davidooi0128-glitch/medicine-dispenser-for-MCM-competition-2025/slide 2 document.docx

# PILL PING — The Hardware Architecture and Innovation

### 1: Hygienic Liquid Delivery (Peristaltic Pump)

- Operating Principle: Operates on a planetary gearbox kinematic model. The central motor shaft acts as the sun gear, driving three planetary rollers to compress medical-grade silicone tubing in a peristaltic motion.
- Biomedical Safety: Complete physical isolation of liquid media. Fluid path is restricted strictly inside the silicone tube, eliminating cross-contamination and reagent oxidation.
- Control Mechanism: High-torque DC motor driven via relay switch.

### 2: Closed-Loop Liquid Dosing (Hall-Effect Encoder)

- Feedback Architecture: Rear-shaft mounted PCB featuring a magnetic encoder disc and Hall-effect sensing elements.
- Signal Acquisition: Generates high-frequency pulse interrupts directly to the microcontroller upon shaft rotation.
- Performance Metric: Enables closed-loop volume metering down to 0.01 mL (10 µL), compensating for liquid viscosity changes and voltage dips.

### 3: PWM Servo Motor vs. Stepper Motor Actuation Analysis

Parameter | PWM Servo Motor (Selected) | Stepper Motor (Alternative Rejected)
Control Architecture | Closed-loop (Internal potentiometer feedback) | Open-loop (Step counting)
Power Consumption | Dynamic (Draws current only under load) | Constant static power draw (Holding torque)
Homing Requirement | Not required (Absolute position feedback) | Requires dedicated homing/limit switch
Fault Tolerance | Self-correcting against external blockage | Vulnerable to lost steps during jamming

### 4: Pill Drop Verification (Laser Optical Sensor)

- Sensor Topology: Cross-chute opposing laser emitter and photodiode detector pair (PIN_LASER).
- Verification Protocol: Interruption of the optical beam triggers a hardware interrupt.
- Data Integrity: Medication dispensation logs are updated in EEPROM only after verified physical passage of a solid pill through the beam, preventing false-positive dispensing records.

### 5: Smart Rotary Solid Dispenser

- Mechanical Structure: Custom 3D-printed multi-compartment indexing wheel driven by servo micro-stepping.
- Dispensing Kinematics: Programmatic angular indexing isolates individual solid doses, ensuring exactly one pill is released per rotation cycle.

### 6: Dedicated IoT Web Server (ESP8266 Module)

- Networking Protocol: Configured in standalone Access Point (SoftAP) mode hosting a lightweight HTTP Web Server.
- User Interface: Zero-dependency browser interface for schedule management (dosing window, target pulse count, pill quantities) without requiring external app installations.

## 7. Dual-MCU Architecture & Hardware Resource Allocation

The system decouples network communication from real-time hardware execution using a Dual-MCU topology.

Feature / Resource | Arduino Core (ATmega328P) | ESP8266 Module | System Task Division
Pin Density | 14 Digital I/O (6 PWM) + 8 Analog (A0–A7) | Extremely limited (~4 usable GPIOs) | Arduino: Handles 10+ sensors/actuators. ESP8266: Dedicated network stack.
Hardware Interrupts | Fast hardware pin interrupts (D2, D3) | Shared with Wi-Fi stack | Arduino: Zero-latency Hall pulse counting and laser beam break detection.
Communication Buses | Hardware I2C (SDA/SCL), SPI, Native UART | Software I2C, UART | Arduino: Direct interface with I2C LCD, Servo PWM, and Analog Sensors.
Memory Isolation | 1 KB Non-Volatile EEPROM | Flash Memory / SPIFFS | Arduino: Stores dosage schedules safely against power failure.

### Inter-MCU Protocol & Data Persistence

1. Communication Protocol: SoftwareSerial UART bridge at 9600 baud (Arduino D2/D3 $\leftrightarrow$ ESP8266 TX/RX).
2. Payload Framing: Data transmitted using framed ASCII packets: <Doses,Start,End,Remind,Pulses,Pills>.
3. Data Security: Parsed schedules are immediately saved into the Arduino core’s internal EEPROM, preserving dosage timing through sudden power losses.

## 8. Audio-Visual Alert System (Module 8)

- Multi-Modal Warning: High-decibel piezo buzzer coupled with high-luminance flashing LED arrays.
- Escalation Protocol: Triggers active alerting during scheduled dosing windows. Escalates tone patterns if dosage remains uncollected past the target end time.

————————————————————————————————————————————————————

## Future Roadmap & Enterprise Hospital Expansion

### Phase 1: RFID Patient Authentication (Public Hospital Corridors)

- Target Environment: Transition from home care to ward corridors and communal hospital areas.
- Implementation: Integration of an SPI/I2C RFID reader (e.g., RC522) to the Arduino core. Patients wearing encoded RFID wristbands scan at hallway stations to receive scheduled medication on demand, reducing nursing workload.

### Phase 2: Centralized Network Management

- Infrastructure: Integration of SPI-based W5500 Ethernet modules or Enterprise WPA2 Wi-Fi bridges.
- Functionality: Enables central nursing stations to monitor live dispensing status, track adherence logs, and push real-time schedule adjustments across entire hospital floors.

### Phase 3: Modular Hardware Expansion

Frame Design: Physical chassis featuring standardized snap-on sliding rails.

Stackable Modules: Auxiliary 3D-printed "Servo + Rotary Wheel" and "Peristaltic Pump" modules connect via extended I2C/PWM buses, dynamically scaling solid tablet and liquid capacity without redesigning the main controller board.

EXPLODED VIEW :

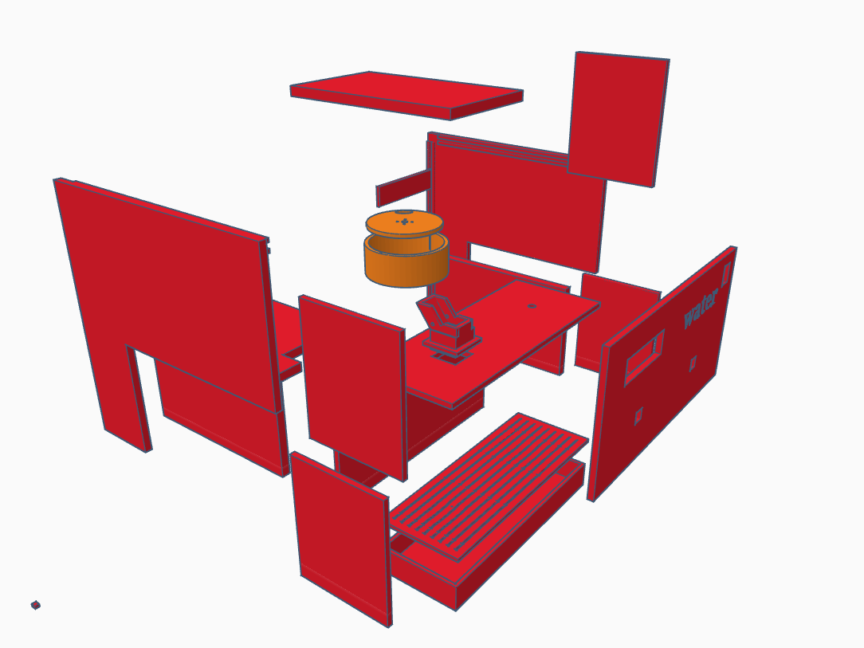
[picture p1: figure]
