davidooi0128-glitch/medicine-dispenser-for-MCM-competition-2025/arduino expension/PCB PDF (1).pdf

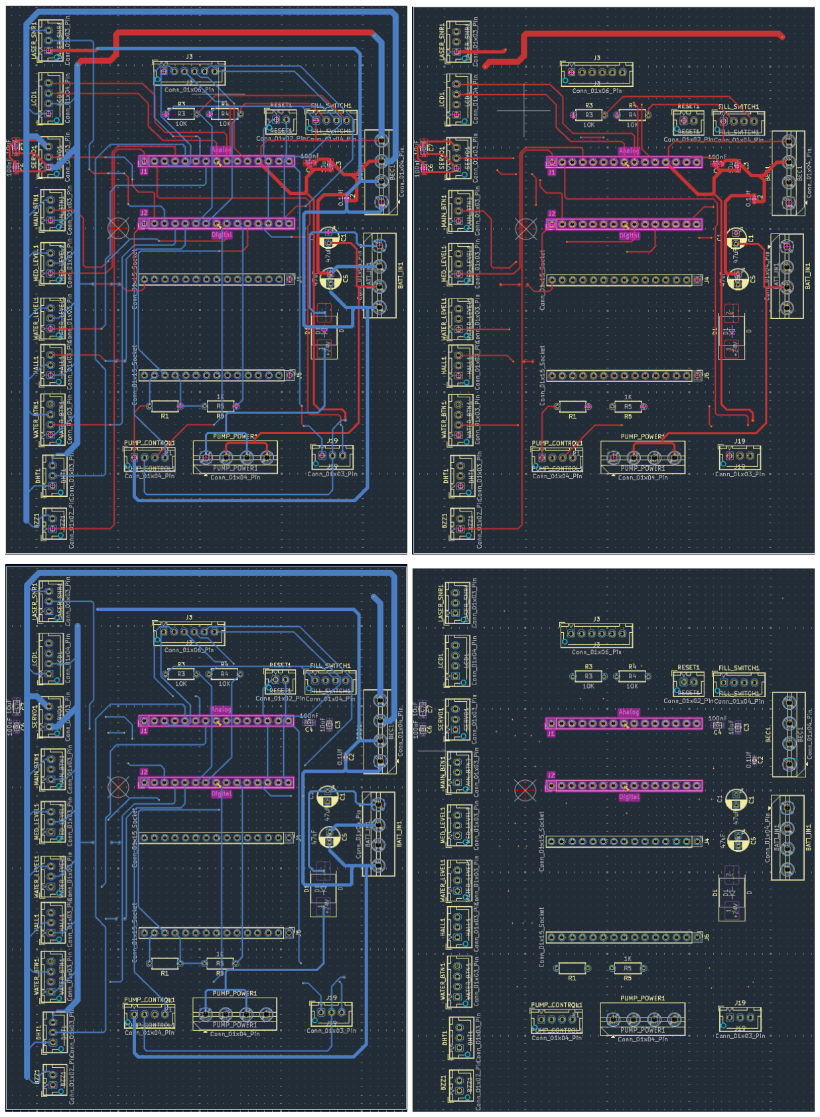
[picture p2: page 1]
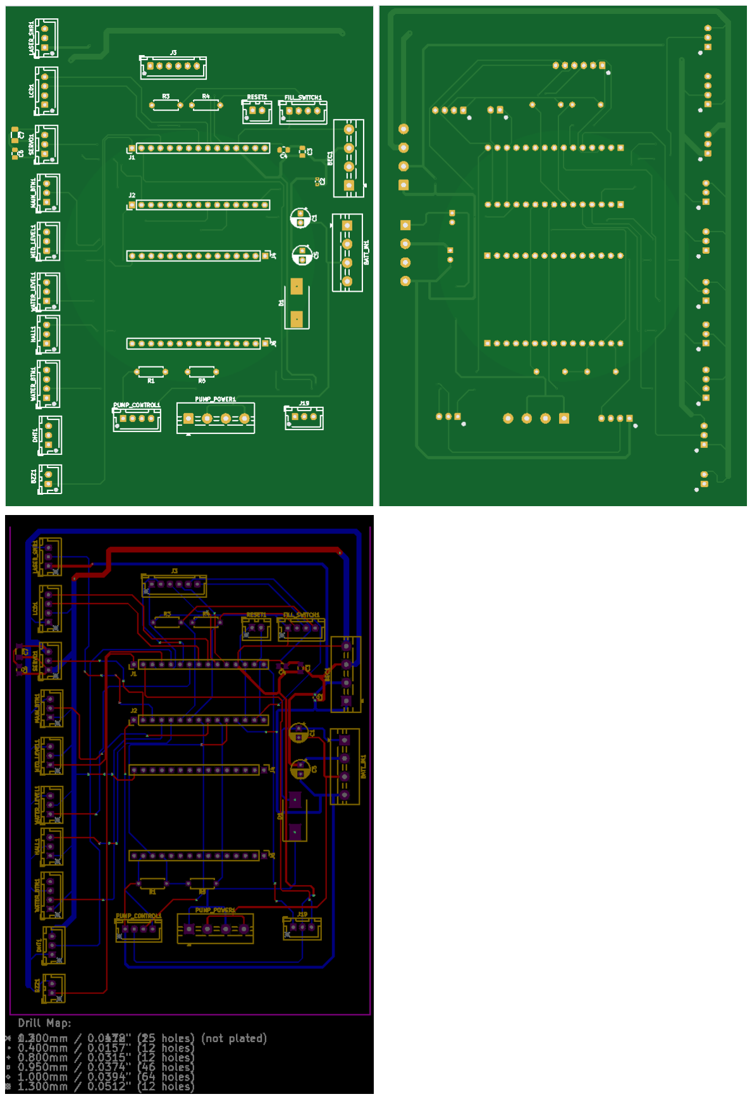
[picture p3: page 2]

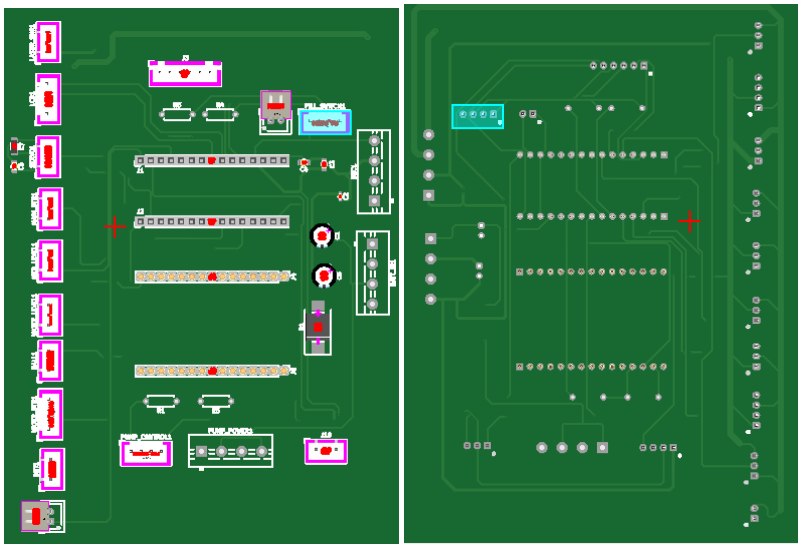
[picture p4: figure]
