davidooi0128-glitch/medicine-dispenser-for-MCM-competition-2025/display board-20260913T150620Z-1-001/display board/2.png

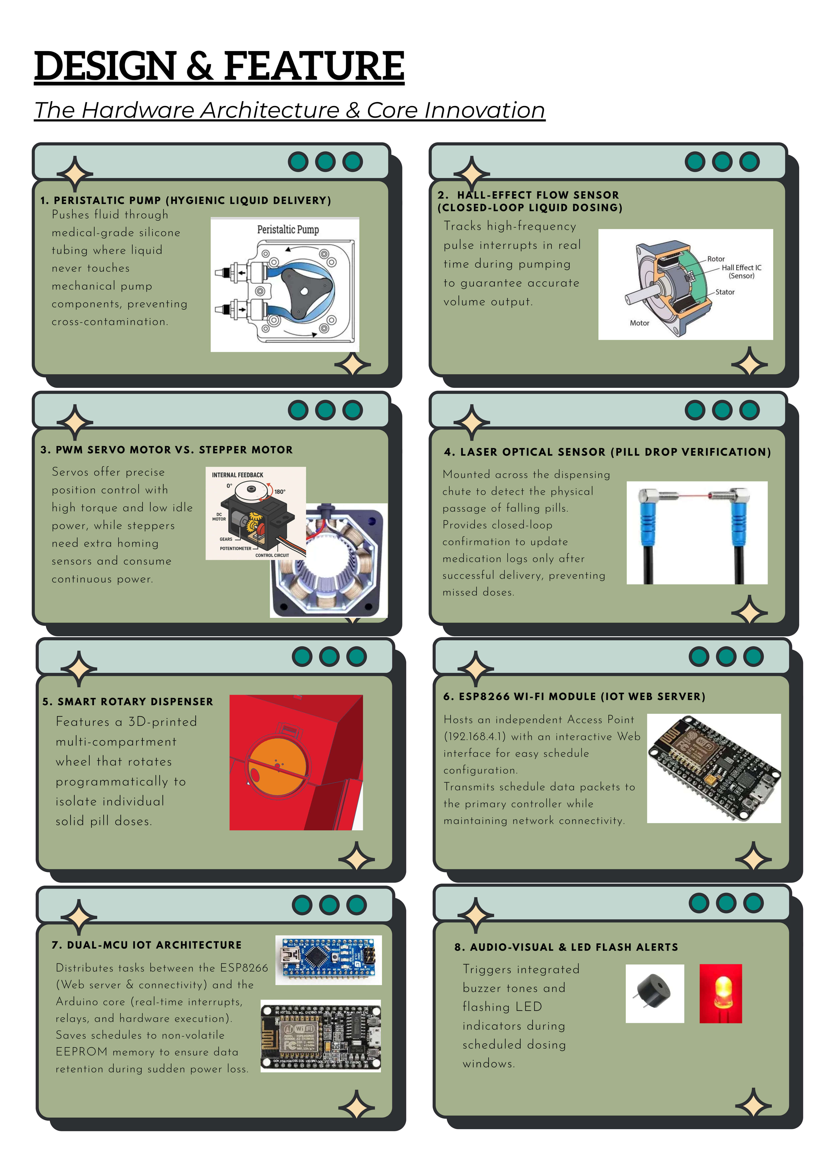
display board-20260913T150620Z-1-001/display board/2.png
