davidooi0128-glitch/medicine-dispenser-for-MCM-competition-2025/Screenshot_2026-09-13-14-38-49-51_40deb401b9ffe8e1df2f1cc5ba480b12.jpg

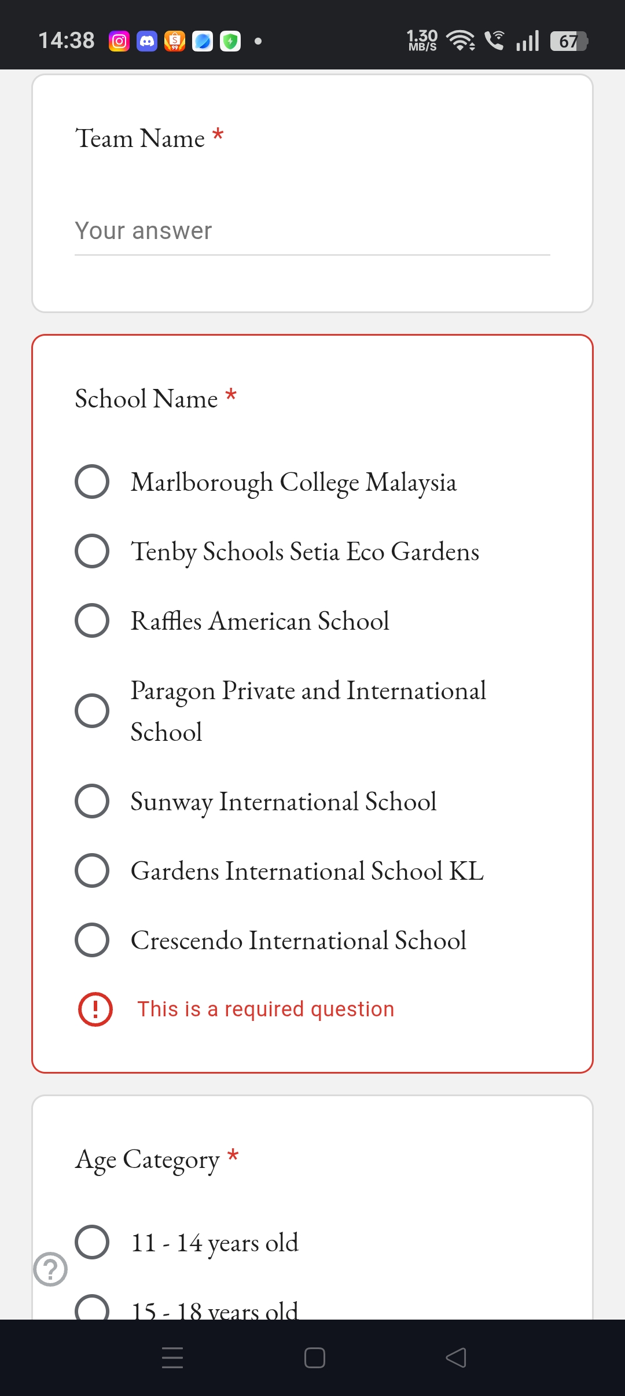
Screenshot_2026-09-13-14-38-49-51_40deb401b9ffe8e1df2f1cc5ba480b12.jpg
