davidooi0128-glitch/medicine-dispenser-for-MCM-competition-2025/arduino expension/production/bom.csv

Designator | Footprint | Quantity | Value | LCSC Part #
BATT_IN1, BEC1, PUMP_POWER1 | TerminalBlock_MaiXu_MX126-5.0-04P_1x04_P5.00mm | 3 | Conn_01x04_Pin
BZZ1, RESET1 | JST_XH_B2B-XH-AM_1x02_P2.50mm_Vertical | 2 | Conn_01x02_Pin
C1, C5 | CP_Radial_D5.0mm_P2.50mm | 2 | 47uF
C2 | 0603 | 1 | 0.1Uf
C3 | 0805 | 1 | 10uF
C4, C6 | 0805 | 2 | 100nF
C7 | 1206 | 1 | 10uF
D1 | D_SMC_Handsoldering | 1 | D
DHT1, HALL1, J19, LASER_SNR1, MAIN_BTN1, MED_LEVEL1, SERVO1, WATER_LEVEL1 | JST_XH_B3B-XH-AM_1x03_P2.50mm_Vertical | 8 | Conn_01x03_Pin
FILL_SWITCH1, LCD1, PUMP_CONTROL1 | JST_XH_B4B-XH-AM_1x04_P2.50mm_Vertical | 3 | Conn_01x04_Pin
J1 | PinHeader_1x15_P2.54mm_Vertical | 1 | Analog
J2 | PinHeader_1x15_P2.54mm_Vertical | 1 | Digital
J3 | JST_XH_B6B-XH-AM_1x06_P2.50mm_Vertical | 1 | Conn_01x06_Pin
J4, J6 | PinHeader_1x15_P2.54mm_Vertical | 2 | Conn_01x15_Socket
R1 | R_Axial_DIN0207_L6.3mm_D2.5mm_P7.62mm_Horizontal | 1 | 2K
R3, R4 | R_Axial_DIN0207_L6.3mm_D2.5mm_P7.62mm_Horizontal | 2 | 10K
R5 | R_Axial_DIN0207_L6.3mm_D2.5mm_P7.62mm_Horizontal | 1 | 1K
WATER_BTN1 | JST_XH_B4B-XH-AM_1x04_P2.50mm_Vertical | 1 | Conn_01x03_Pin
