davidooi0128-glitch/medicine-dispenser-for-MCM-competition-2025/arduino expension/arduino expension.csv

Reference | Value | Datasheet | Footprint | Qty | DNP
C1,C2,C3,C4,C5,C6,C7 | C |  | Capacitor_SMD:C_0603_1608Metric,Capacitor_SMD:C_0805_2012Metric_Pad1.18x1.45mm_HandSolder,Capacitor_SMD:C_1206_3216Metric_Pad1.33x1.80mm_HandSolder,Capacitor_THT:CP_Radial_D5.0mm_P2.50mm | 7
D1 | D |  | Diode_SMD:D_SMC_Handsoldering | 1
J1 | Analog |  | Connector_PinHeader_2.54mm:PinHeader_1x15_P2.54mm_Vertical | 1
J2 | Digital |  | Connector_PinHeader_2.54mm:PinHeader_1x15_P2.54mm_Vertical | 1
J3 | Conn_01x06_Pin |  | Connector_JST:JST_XH_B6B-XH-AM_1x06_P2.50mm_Vertical | 1
J4,J6 | Conn_01x15_Socket |  | Connector_PinHeader_2.54mm:PinHeader_1x15_P2.54mm_Vertical | 2
J5,J7,J8,J13,J20,J21 | Conn_01x04_Pin |  | Connector_JST:JST_XH_B4B-XH-AM_1x04_P2.50mm_Vertical,TerminalBlock:TerminalBlock_MaiXu_MX126-5.0-04P_1x04_P5.00mm | 6
J9,J10,J11,J12,J14,J15,J16,J17,J19 | Conn_01x03_Pin |  | Connector_JST:JST_XH_B3B-XH-AM_1x03_P2.50mm_Vertical,Connector_JST:JST_XH_B4B-XH-AM_1x04_P2.50mm_Vertical | 9
J18,J22 | Conn_01x02_Pin |  | Connector_JST:JST_XH_B2B-XH-AM_1x02_P2.50mm_Vertical | 2
R1 | 2K |  | Resistor_THT:R_Axial_DIN0207_L6.3mm_D2.5mm_P7.62mm_Horizontal | 1
R3,R4 | 10K |  | Resistor_THT:R_Axial_DIN0207_L6.3mm_D2.5mm_P7.62mm_Horizontal | 2
R5 | 1K |  | Resistor_THT:R_Axial_DIN0207_L6.3mm_D2.5mm_P7.62mm_Horizontal | 1
