davidooi0128-glitch/medicine-dispenser-for-MCM-competition-2025/Exploded view.stl

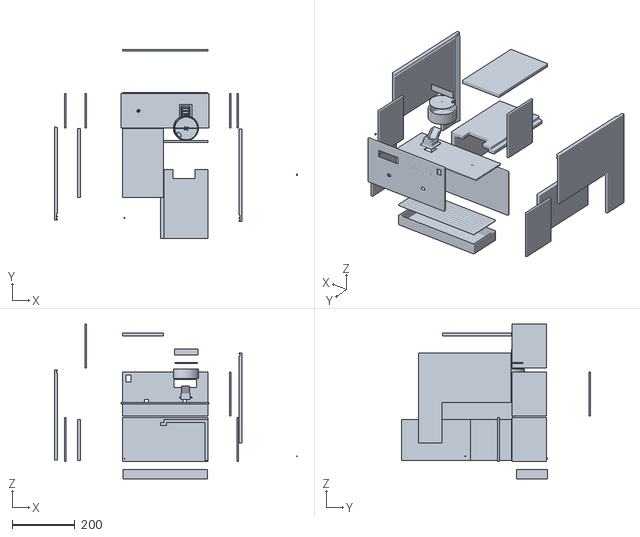
[picture p9: CAD file, 2026-09-13]
Exploded view.stl
773.0 x 601.0 x 493.0
