davidooi0128-glitch/medicine-dispenser-for-MCM-competition-2025/in conclusion 320020=160 from the experiment we comfirm that 160 hall pulse is approximately equals to 1 ml (3).pdf

# Technical Documentation & Calibration Logbook

ù

÷

ª

[handleWaterSystem]
(Water & Liquid Management)
⏰ [checkAlarms] |
(Alarm Time Detection)
│ | │ | │
├─ Standby: Display Time | └─ Triggers Buzzer Alert | ├─ ⚙
├─ Ö
└─ s

│ & DHT22
├─ 7 Low Med: Flashes
│ "Low Medicine!"
├─ Refill: 16-block level │ bar display
└─ ' Dispense Water: Drives water pump

[User Phone / Web Interface]

(Connects via WiFi & submits schedule data)

[ESP8266 Web Server]

Data Validation (Checks for overlapping dose times)

[Formatted Data Packet: <num,s,e,r,p,p>]

(UART Serial TX➔ Arduino RX)

[Arduino: Receives Data & Saves to EEPROM(Electrically Erasable Programmable Read-Only Memory)] ◄ ►

[executeDispensing]
(Pill&Liquid Dispensing)

Servo rotates for pills
Laser sensor detects drops Drives Pump + Hall Metering

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
─── (Non-volatile memory)
│
▼
⚙ [Arduino Main Loop]
│
├───────────────────────────────┼───────────────────────────────┐
▼ | ▼ | ▼

### -Data validattion

## Buzzer Signal Arduino D13 (PIN_BUZZER) Audio alert and alarm output

## IN2 Water Pump Relay Arduino D12 (PIN_WATER_PUMP) Control signal for drinking water pump

## PWM Servo Motor Arduino D11 (PIN_SERVO) PWM signal for pill dispensing mechanism

## Laser Sensor Signal Arduino D10 (PIN_LASER) Optical beam drop detector for pill passage

Water Dispense Button Signal Arduino D9 (PIN_WATER_BUTTON) Manual drinking water dispense trigger input
Hall Flow Sensor Signal Arduino D8 (PIN_HALL) Pulse counting for liquid medicine dispensing

Medicine Fill Limit Switch Signal Arduino D7 (PIN_MED_FILL_SWITCH) Medicine tank refill detection input
Water Fill Limit Switch Signal Arduino D6 (PIN_FILL_SWITCH) Drinking water tank refill detection input

## IN1 Medicine Pump Relay Arduino D5 (PIN_MED_PUMP) Control signal for liquid medicine pump

Main Dispense Button Signal Arduino D4 (PIN_MAIN_BUTTON) Manual pill dispensing trigger input
Water Level Sensor Signal Arduino A3 (PIN_WATER_LEVEL) Analog drinking water tank level measurement

DATA DHT Temp & Humidity Sensor Arduino A1 (PIN_DHT) Single-bus temperature & humidity data input
Medicine Level Sensor Signal Arduino A0 (PIN_MED_LEVEL) Analog medicine tank level measurement

## VCC / GND 5V / GND Power supply and common ground

## SCL Arduino A5 I2C Clock Line

## SDA LCD 1602 (I2C) Arduino A4 I2C Data Line

## VCC / GND Power supply and common ground 3.3V / GND

## RX Arduino D3 (PIN_ESP_TX) Software Serial TX (Sends data to 3.3V RX via voltage

## TX ESP8266 WiFi Arduino D2 (PIN_ESP_RX) Software Serial RX (Receives data from ESP8266)

## Component / Module Pin Arduino Pin / Connection Description / Function

# data collected of hall sensor realiblity ,accuracy and logbook for ratio of pulse and volume (to find the relationship

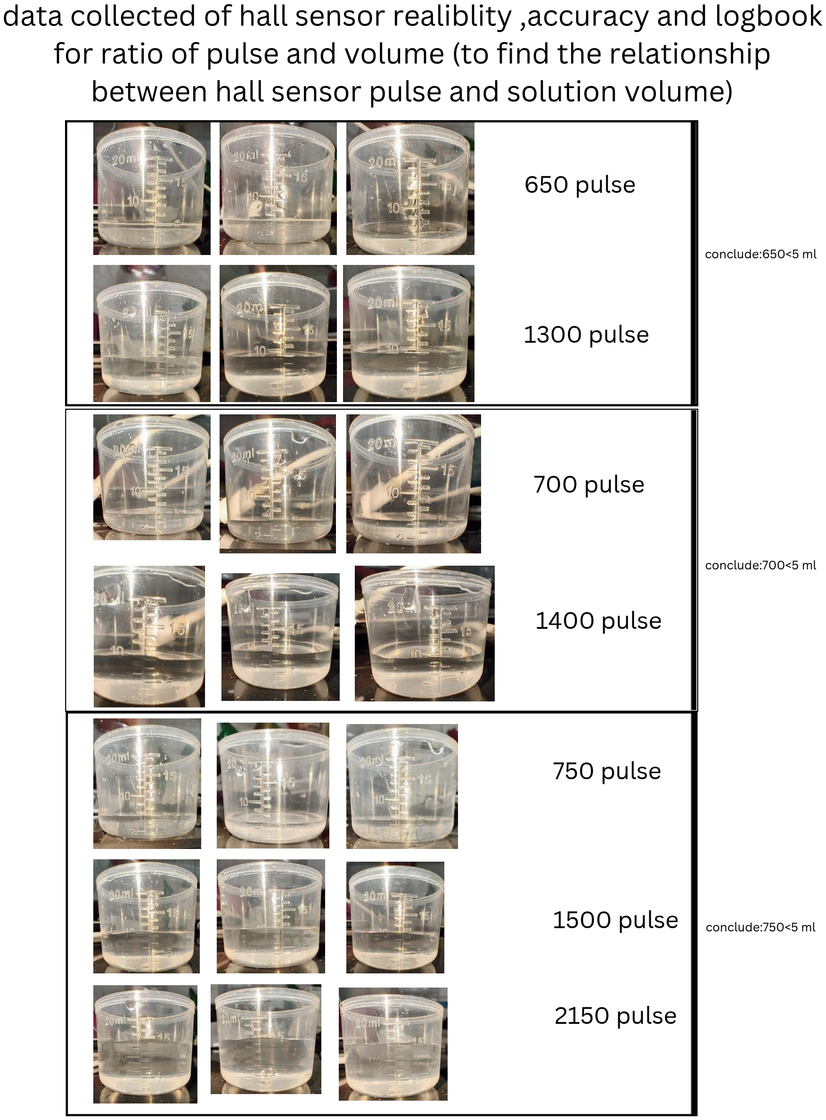
[picture p10: page 4]

# between hall sensor pulse and solution volume)

# 650 pulse

# 1300 pulse

# 700 pulse

# 1400 pulse

# 750 pulse

# 2150 pulse

1500 pulse conclude:750<5 ml

conclude:700<5 ml

conclude:650<5 ml

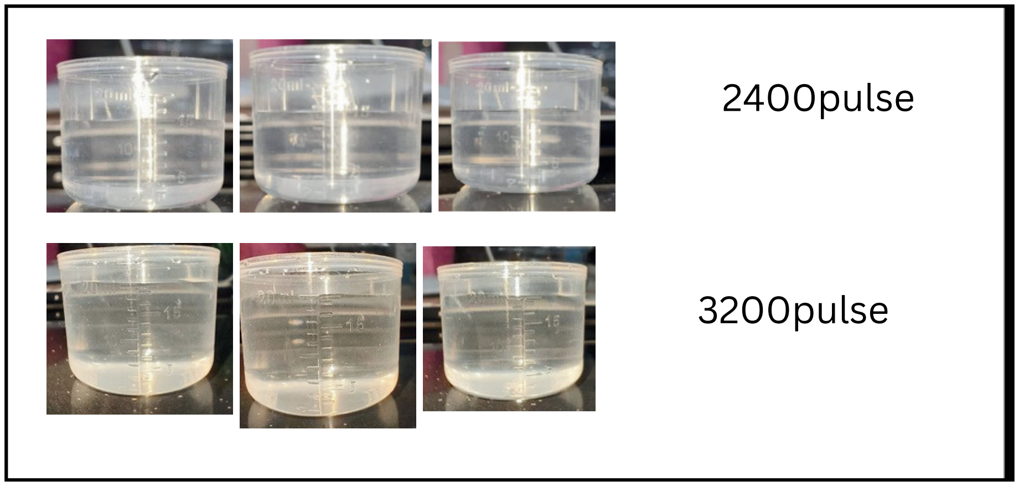
[picture p11: figure]
3200pulse; 2400pulse

conclude:3200≈20ml
2400≈15ml

# in conclusion 3200/20=160 from the experiment we comfirm that 160 hall pulse is approximately equals to 1 ml

2

1

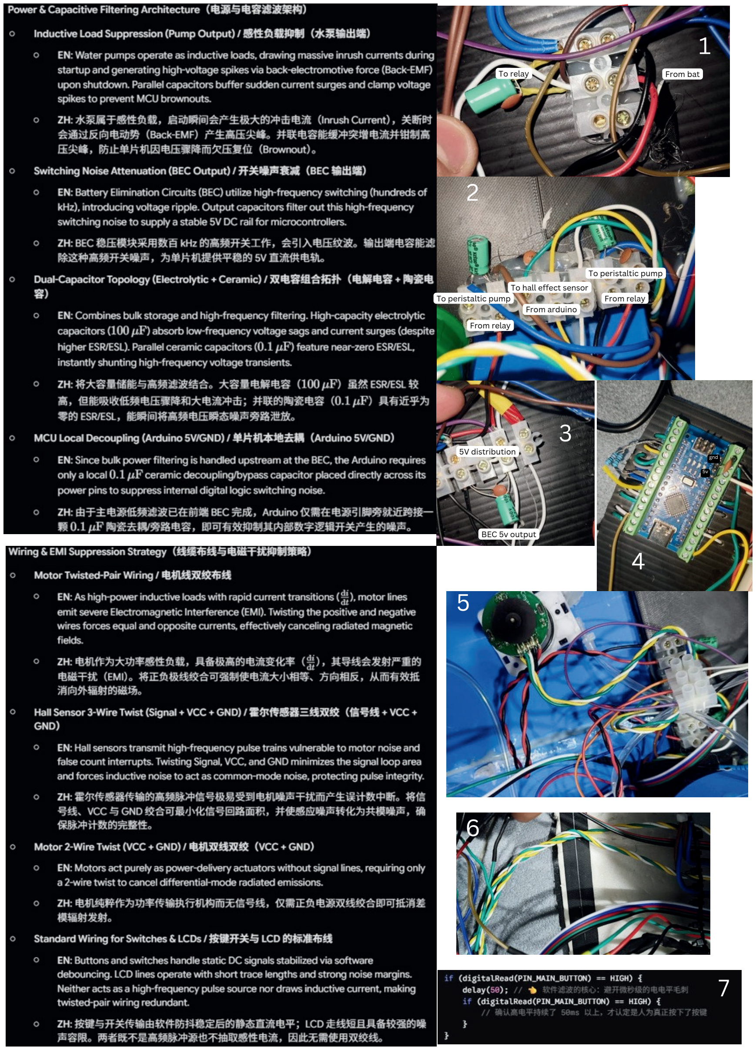
[picture p12: page 6]

To peristaltic pump

To peristaltic pump

gnd

5v

5

6

3

4

To hall effect sensor

To relay | From bat

From relay

From relay
From arduino

5V distribution

BEC 5v output

7

`1k R

2k R

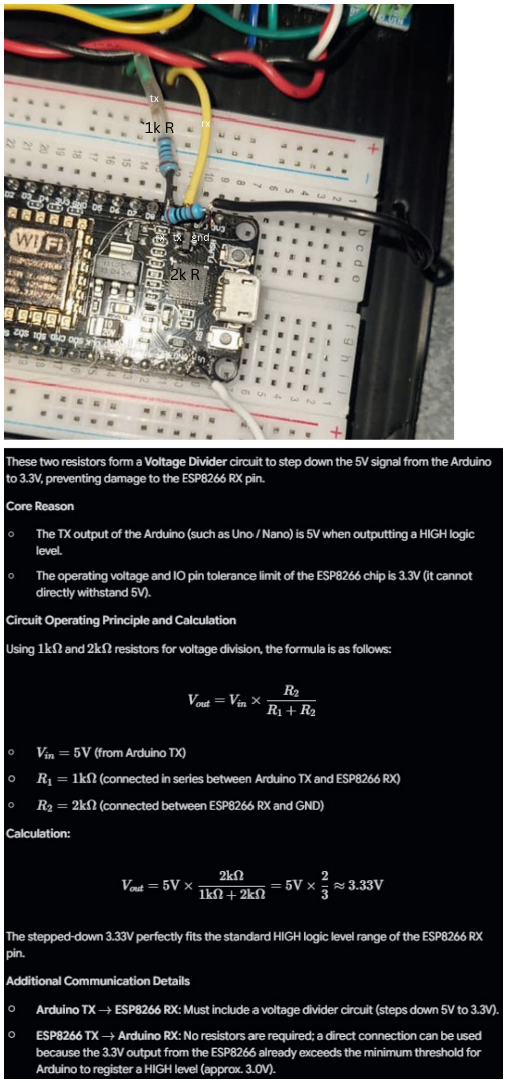
[picture p13: page 7]

tx

rx tx gnd

rx

# operator guide

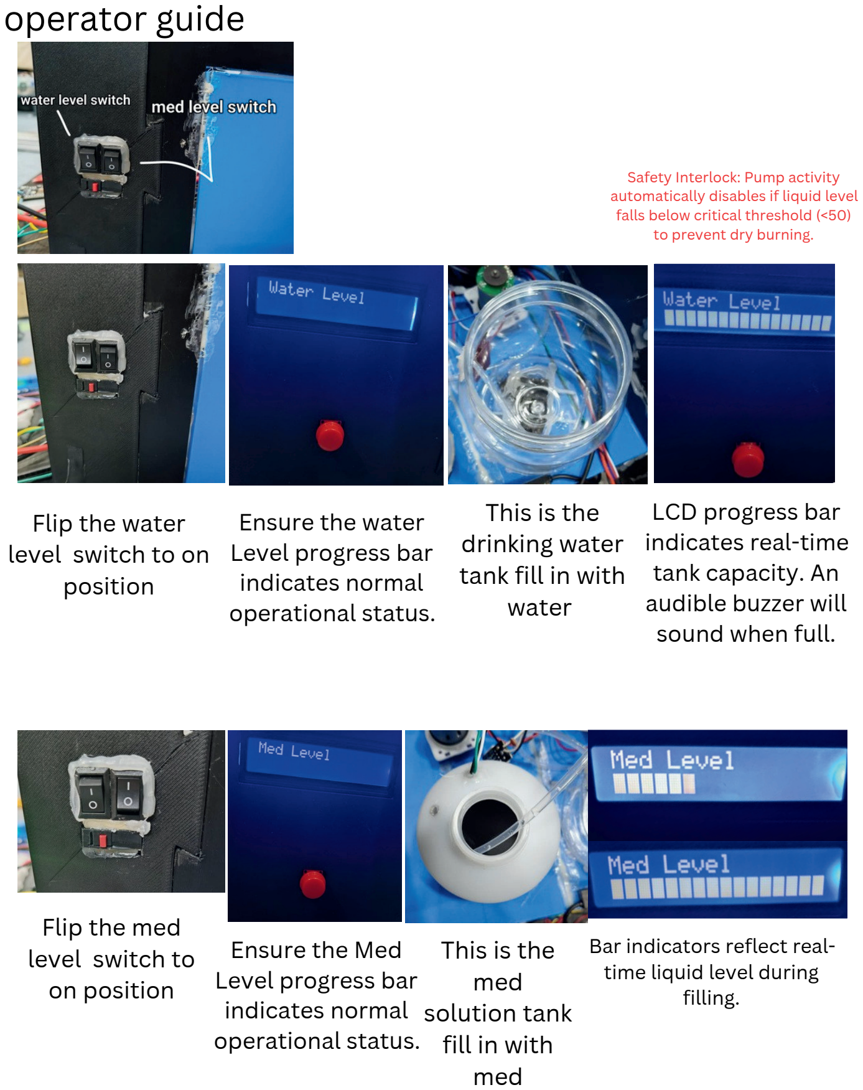
[picture p14: page 8]

# Flip the med level switch to on position

# Flip the water level switch to on position

# Ensure the Med Level progress bar indicates normal

operational status.

# Ensure the water Level progress bar indicates normal

operational status.

# This is the med solution tank fill in with med

# This is the drinking water tank fill in with water

# LCD progress bar indicates real-time tank capacity. An audible buzzer will

sound when full.

## Bar indicators reflect real-time liquid level during

filling.

### Safety Interlock: Pump activity automatically disables if liquid level falls below critical threshold (<50)

to prevent dry burning.

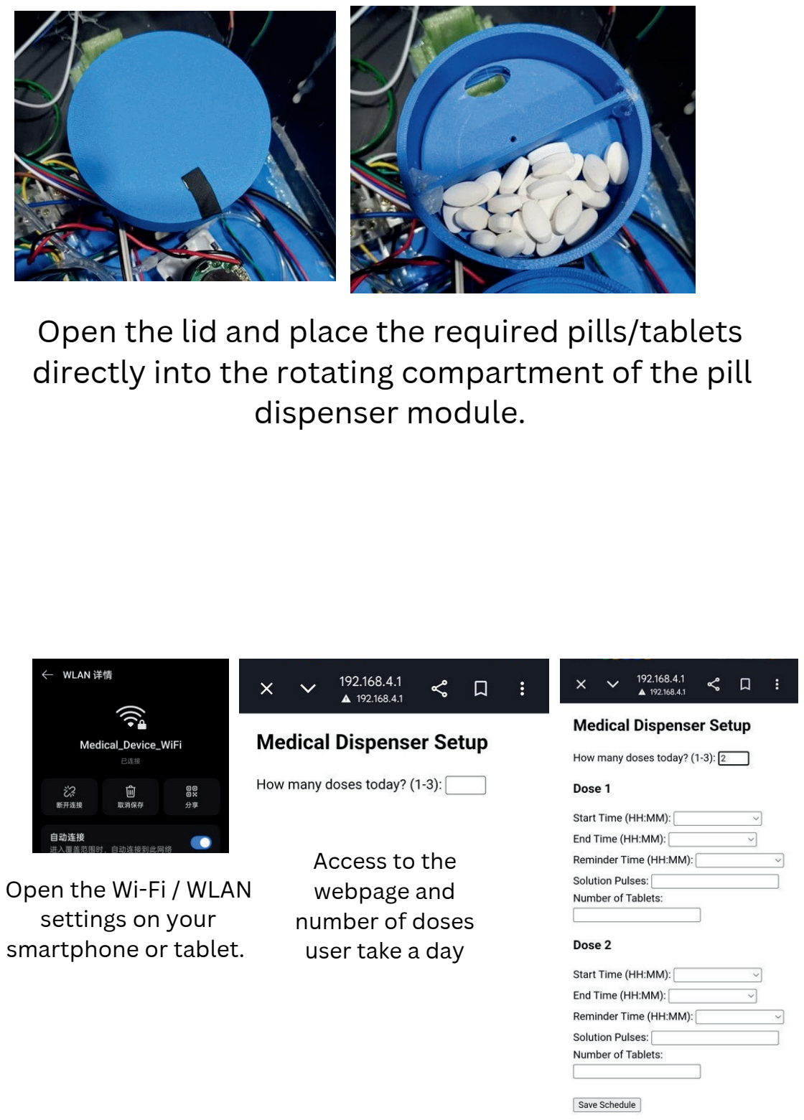
[picture p15: page 9]

# Open the lid and place the required pills/tablets directly into the rotating compartment of the pill

dispenser module.

# Open the Wi-Fi / WLAN settings on your

smartphone or tablet.

# Access to the webpage and number of doses user take a day

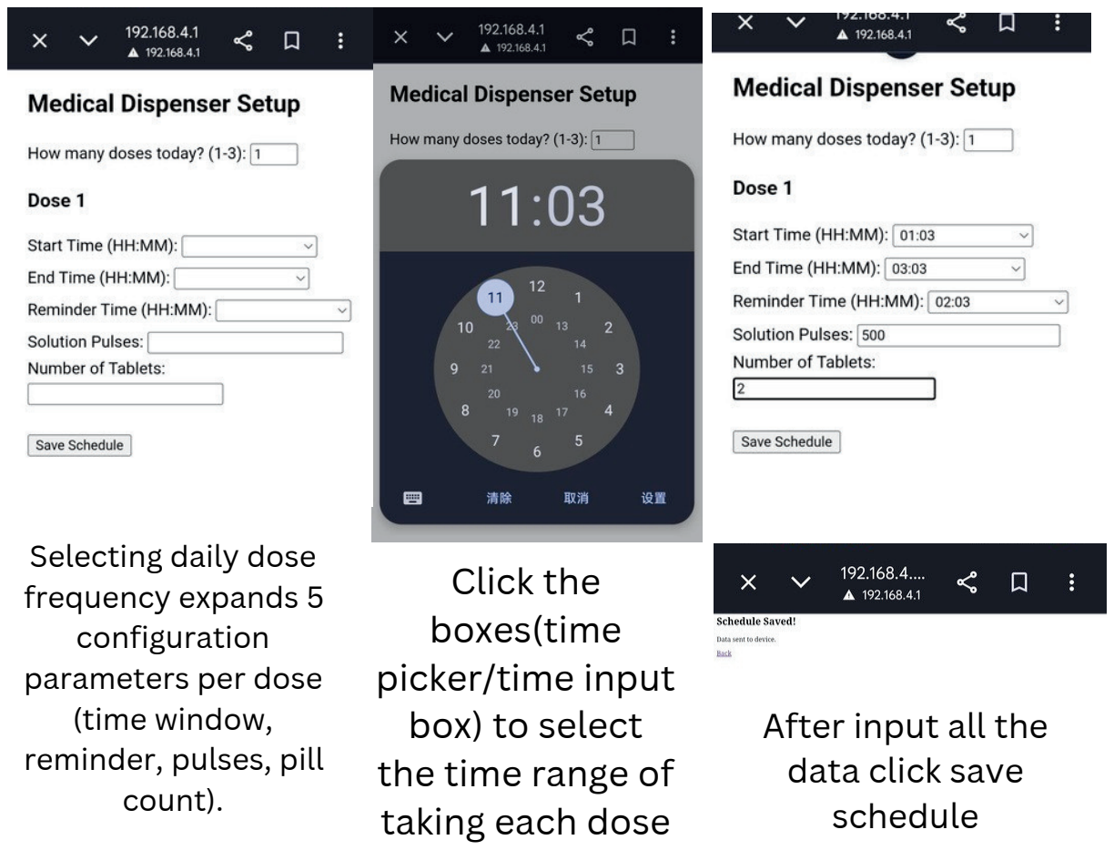
[picture p16: page 10]

# Click the boxes(time picker/time input box) to select the time range of taking each dose

# Selecting daily dose frequency expands 5 configuration parameters per dose

(time window,

# reminder, pulses, pill

count).

# After input all the data click save schedule
