davidooi0128-glitch/medicine-dispenser-for-MCM-competition-2025/network schematic digram file-20260913T150749Z-1-001/network schematic digram file/latest colour plot.pdf

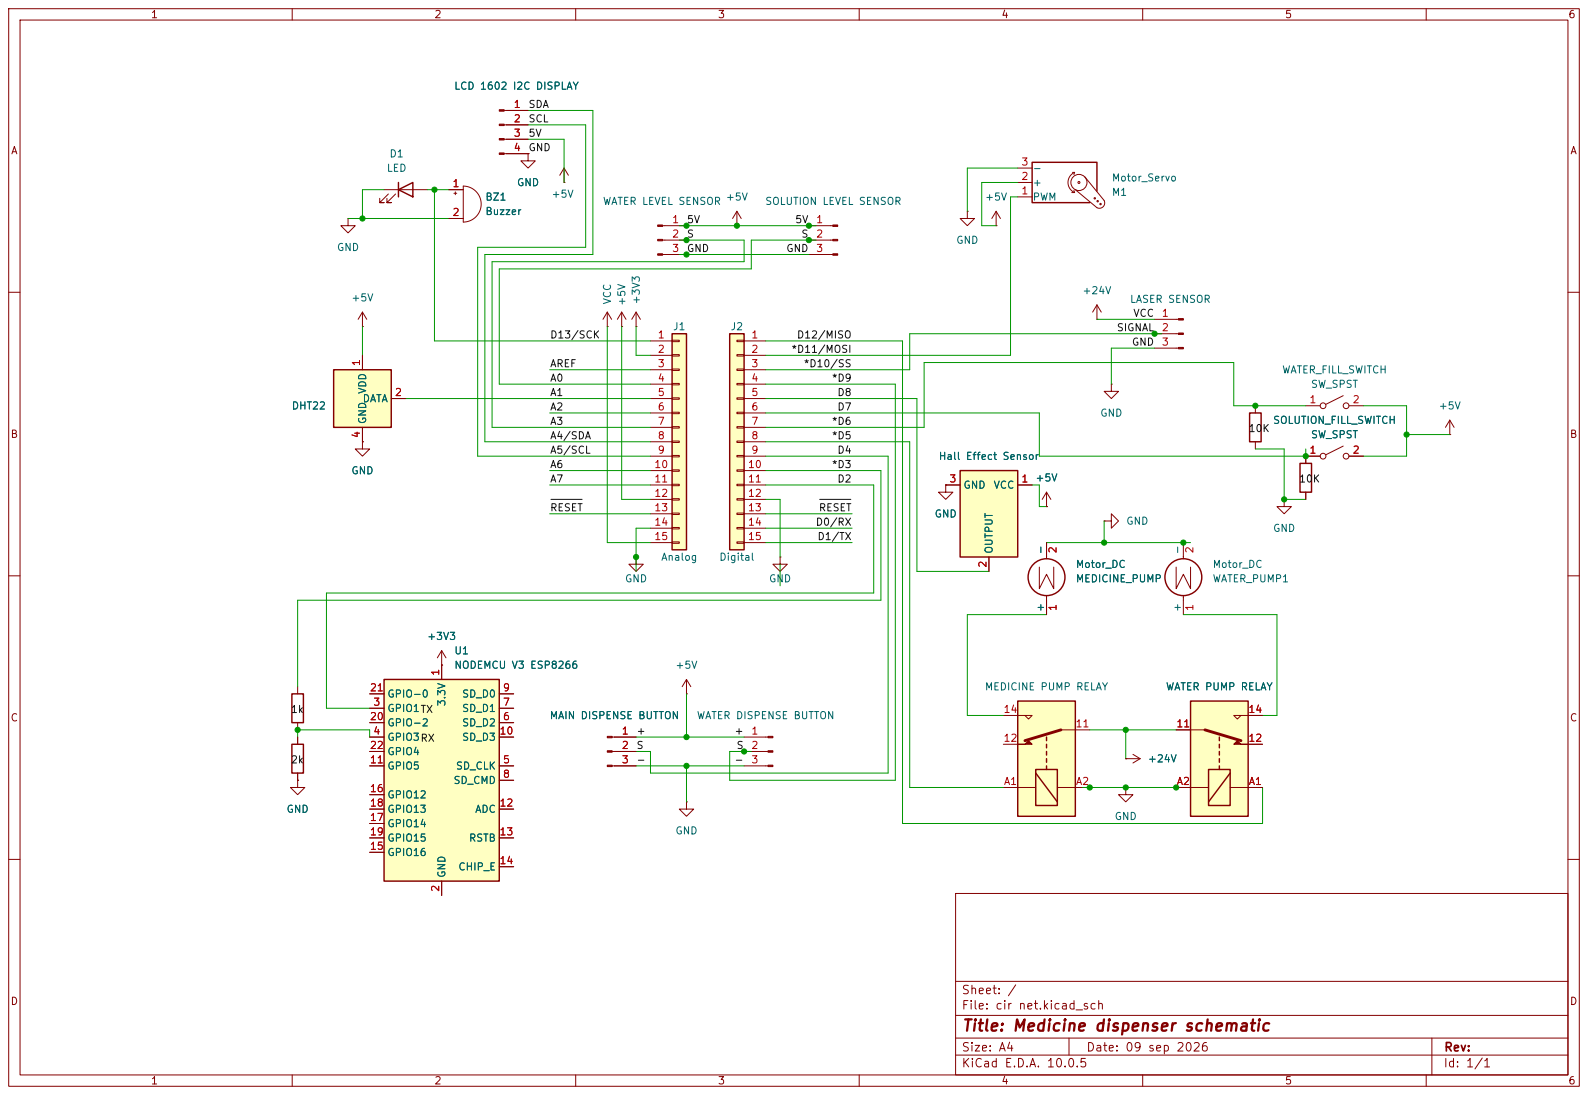
[picture p17: page 1]

3 MAIN DISPENSE BUTTON +3V3 GND

4 GND Hall Effect Sensor VCC 1 OUTPUT 2 GND 3 +5V GND WATER PUMP RELAY 11

File: cir net.kicad_sch
Title: Medicine dispenser schematic

Size: A4 | Rev:
KiCad E.D.A. 10.0.5 | Id: 1/1
