davidooi0128-glitch/medicine-dispenser-for-MCM-competition-2025/arduino expension/arduino expension.pdf

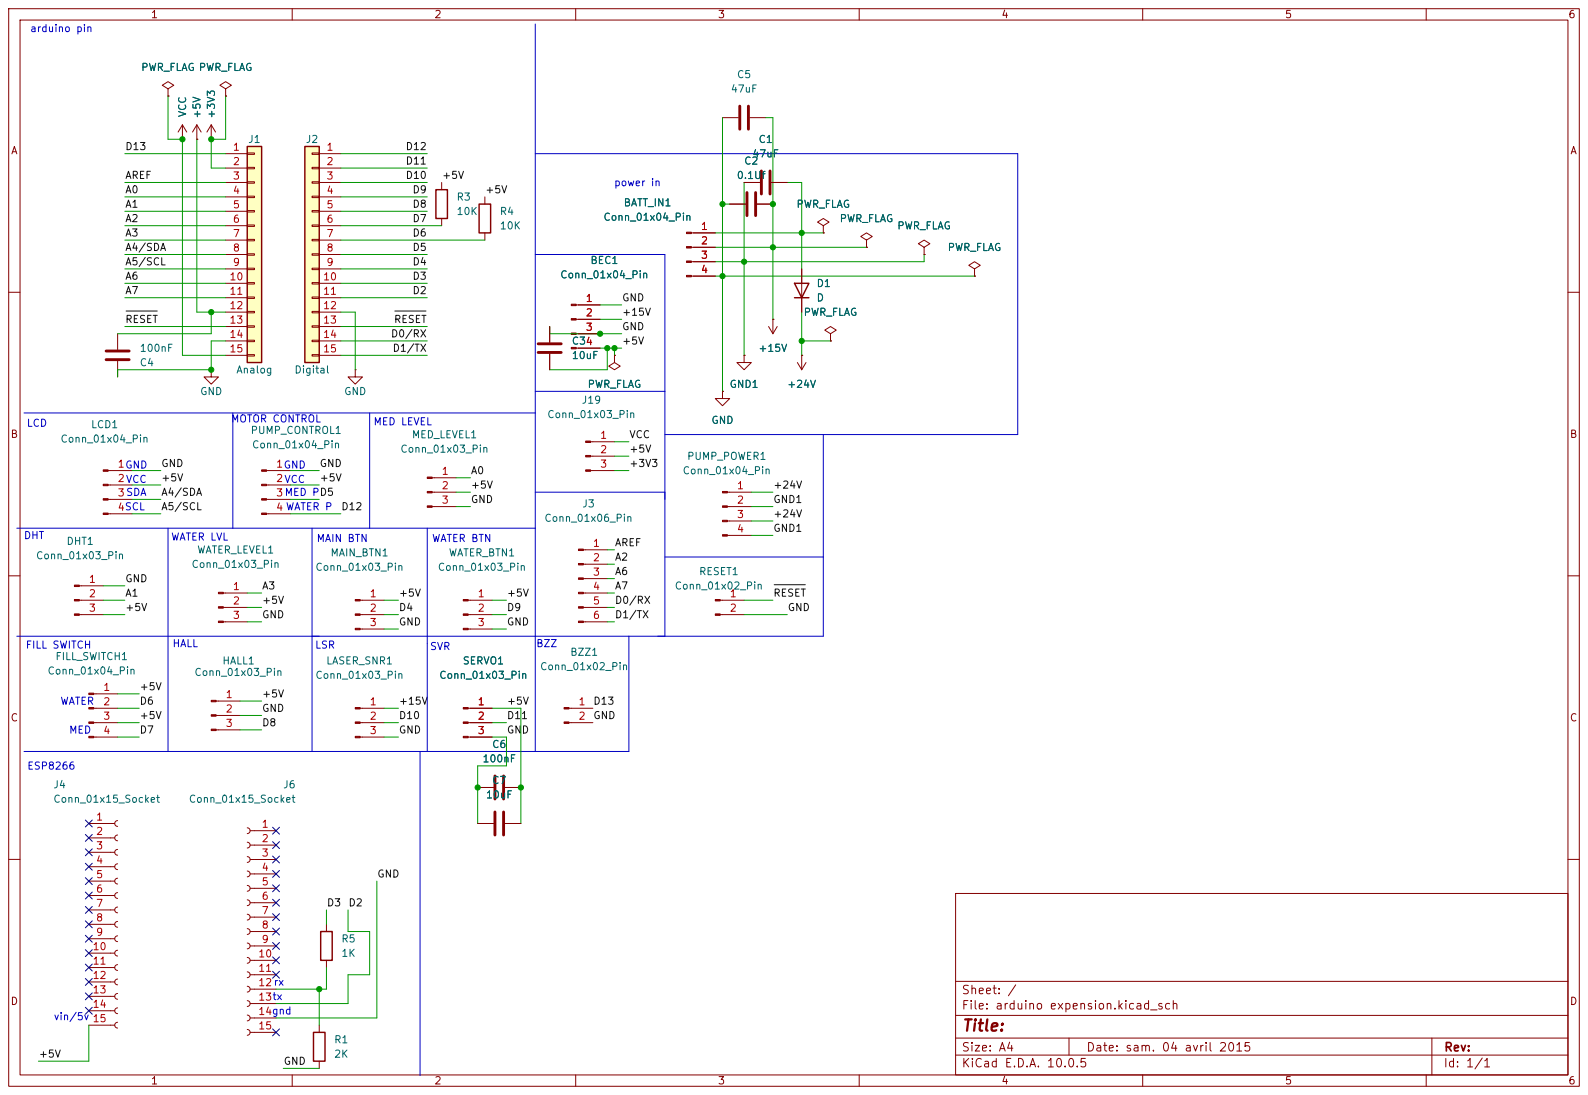
[picture p18: page 1]

Size: A4 | Rev:
KiCad E.D.A. 10.0.5 | Id: 1/1
