davidooi0128-glitch/medicine-dispenser-for-MCM-competition-2025/arduino expension/arduino expension.kicad_pcb

## KiCad design arduino expension/arduino expension.kicad_pcb (2026-10-09)

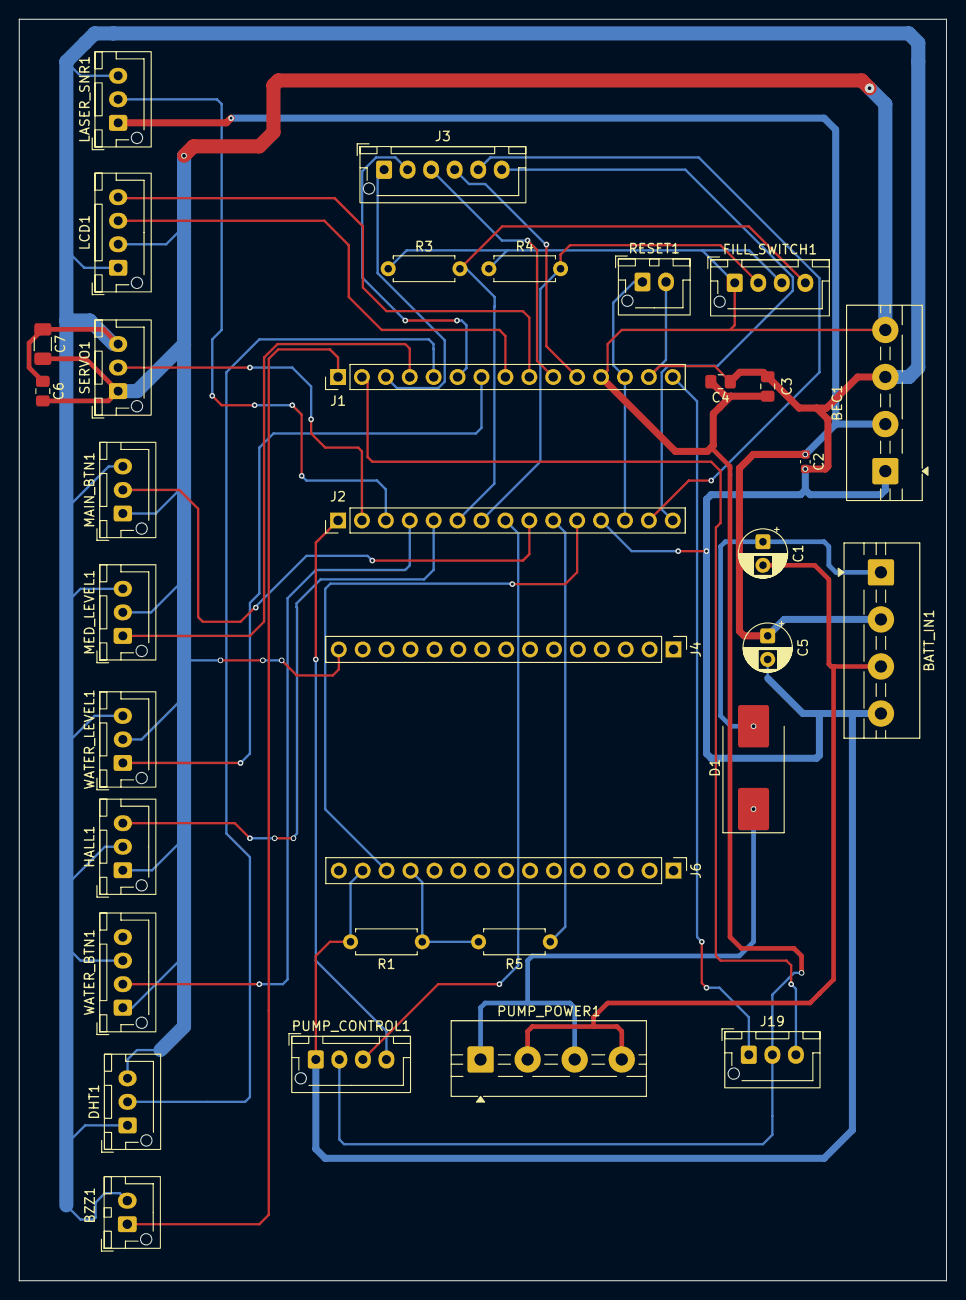
[picture p19: board arduino expension.kicad_pcb from above]

Board: 2 copper layers, 98.5 x 134.0 mm, 34 parts (0 on the bottom side), 33 nets.

Parts:
BATT_IN1: Conn_01x04_Pin; TerminalBlock_MaiXu_MX126-5.0-04P_1x04_P5.00mm
BEC1: Conn_01x04_Pin; TerminalBlock_MaiXu_MX126-5.0-04P_1x04_P5.00mm
BZZ1: Conn_01x02_Pin; JST_XH_B2B-XH-AM_1x02_P2.50mm_Vertical
C1, C5: 47uF; CP_Radial_D5.0mm_P2.50mm
C2: 0.1Uf; C_0603_1608Metric
C3: 10uF; C_0805_2012Metric_Pad1.18x1.45mm_HandSolder
C4, C6: 100nF; C_0805_2012Metric_Pad1.18x1.45mm_HandSolder
C7: 10uF; C_1206_3216Metric_Pad1.33x1.80mm_HandSolder
D1: D; D_SMC_Handsoldering
DHT1: Conn_01x03_Pin; JST_XH_B3B-XH-AM_1x03_P2.50mm_Vertical
FILL_SWITCH1: Conn_01x04_Pin; JST_XH_B4B-XH-AM_1x04_P2.50mm_Vertical
HALL1: Conn_01x03_Pin; JST_XH_B3B-XH-AM_1x03_P2.50mm_Vertical
J1: Analog; PinHeader_1x15_P2.54mm_Vertical
J2: Digital; PinHeader_1x15_P2.54mm_Vertical
J3: Conn_01x06_Pin; JST_XH_B6B-XH-AM_1x06_P2.50mm_Vertical
J4, J6: Conn_01x15_Socket; PinHeader_1x15_P2.54mm_Vertical
J19: Conn_01x03_Pin; JST_XH_B3B-XH-AM_1x03_P2.50mm_Vertical
LASER_SNR1: Conn_01x03_Pin; JST_XH_B3B-XH-AM_1x03_P2.50mm_Vertical
LCD1: Conn_01x04_Pin; JST_XH_B4B-XH-AM_1x04_P2.50mm_Vertical
MAIN_BTN1: Conn_01x03_Pin; JST_XH_B3B-XH-AM_1x03_P2.50mm_Vertical
MED_LEVEL1: Conn_01x03_Pin; JST_XH_B3B-XH-AM_1x03_P2.50mm_Vertical
PUMP_CONTROL1: Conn_01x04_Pin; JST_XH_B4B-XH-AM_1x04_P2.50mm_Vertical
PUMP_POWER1: Conn_01x04_Pin; TerminalBlock_MaiXu_MX126-5.0-04P_1x04_P5.00mm
R1: 2K; R_Axial_DIN0207_L6.3mm_D2.5mm_P7.62mm_Horizontal
R3, R4: 10K; R_Axial_DIN0207_L6.3mm_D2.5mm_P7.62mm_Horizontal
R5: 1K; R_Axial_DIN0207_L6.3mm_D2.5mm_P7.62mm_Horizontal
RESET1: Conn_01x02_Pin; JST_XH_B2B-XH-AM_1x02_P2.50mm_Vertical
SERVO1: Conn_01x03_Pin; JST_XH_B3B-XH-AM_1x03_P2.50mm_Vertical
WATER_BTN1: Conn_01x03_Pin; JST_XH_B4B-XH-AM_1x04_P2.50mm_Vertical
WATER_LEVEL1: Conn_01x03_Pin; JST_XH_B3B-XH-AM_1x03_P2.50mm_Vertical

Connections:
+3V3: J1.2, J19.3
+5V: BEC1.4, C3.2, C4.2, C6.2, C7.2, DHT1.3, FILL_SWITCH1.1, FILL_SWITCH1.3, HALL1.1, J1.12, J4.15 (Pin_15_15), J19.2, LCD1.2, MAIN_BTN1.1, MED_LEVEL1.2, PUMP_CONTROL1.2, R3.1, R4.1, SERVO1.1, WATER_BTN1.1, WATER_LEVEL1.2
+15V: BATT_IN1.2, BEC1.2, C2.1, C5.1, LASER_SNR1.1
+24V: D1.1 (K), PUMP_POWER1.1, PUMP_POWER1.3
/A0: J1.4, MED_LEVEL1.1
/A1: DHT1.2, J1.5
/A2: J1.6, J3.2
/A3: J1.7, WATER_LEVEL1.1
/A4/SDA: J1.8, LCD1.3
/A5/SCL: J1.9, LCD1.4
/A6: J1.10, J3.3
/A7: J1.11, J3.4
/AREF: J1.3, J3.1
/D0/RX: J2.14, J3.5
/D1/TX: J2.15, J3.6
/D2: J2.11, J6.13
/D3: J2.10, R5.1
/D4: J2.9, MAIN_BTN1.2
/D5: J2.8, PUMP_CONTROL1.3
/D6: FILL_SWITCH1.2, J2.7, R4.2
/D7: FILL_SWITCH1.4, J2.6, R3.2
/D8: HALL1.3, J2.5
/D9: J2.4, WATER_BTN1.2
/D10: J2.3, LASER_SNR1.2
/D11: J2.2, SERVO1.2
/D12: J2.1, PUMP_CONTROL1.4
/D13: BZZ1.1, J1.1
/~RESET: J1.13, J2.13, RESET1.1
GND: BATT_IN1.4, BEC1.1, BEC1.3, BZZ1.2, C2.2, C3.1, C4.1, C5.2, C6.1, C7.1, DHT1.1, HALL1.2, J1.14, J2.12, J6.14, LASER_SNR1.3, LCD1.1, MAIN_BTN1.3, MED_LEVEL1.3, PUMP_CONTROL1.1, R1.2, RESET1.2, SERVO1.3, WATER_BTN1.3, WATER_LEVEL1.3
GND1: BATT_IN1.3, C1.2, PUMP_POWER1.2, PUMP_POWER1.4
unnamed: BATT_IN1.1, C1.1, D1.2 (A)
unnamed: J6.12, R1.1, R5.2
VCC: J1.15, J19.1
