davidooi0128-glitch/medicine-dispenser-for-MCM-competition-2025/network schematic digram file-20260913T150749Z-1-001/network schematic digram file/cir net.kicad_sch

## KiCad design network schematic digram file-20260913T150749Z-1-001/network schematic digram file/cir net.kicad_sch (2026-09-13)

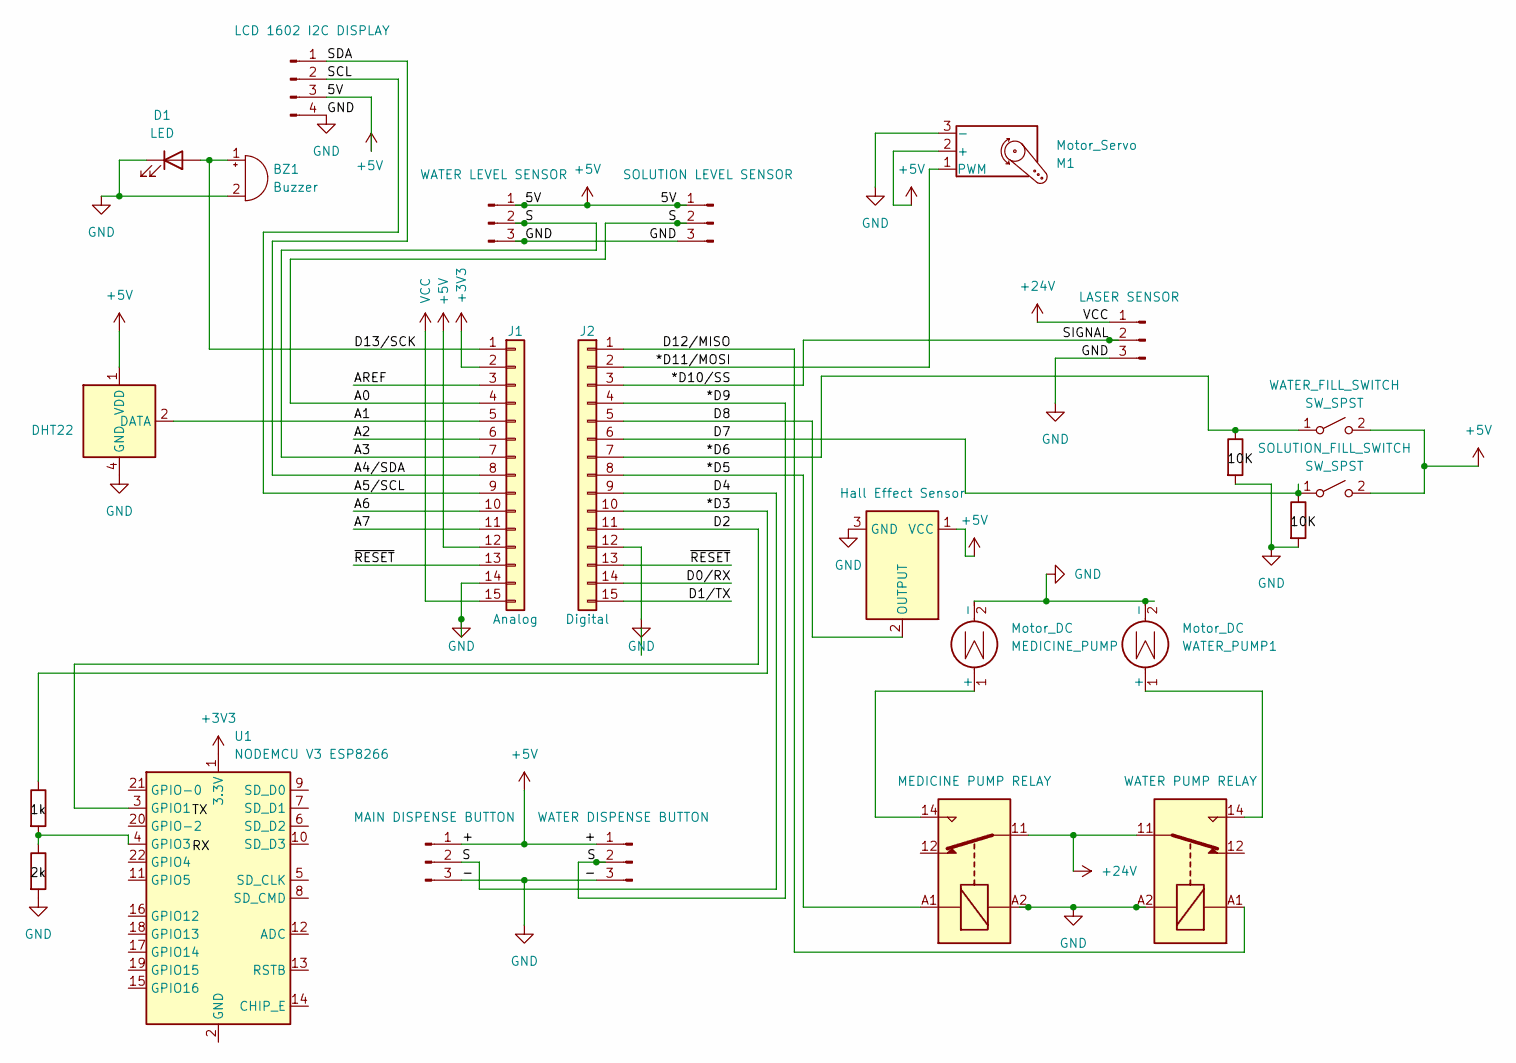
[picture p20: schematic cir net.kicad_sch]

Parts:
BZ1: Buzzer
D1: LED
J1: Analog; PinHeader_1x15_P2.54mm_Vertical
J2: Digital; PinHeader_1x15_P2.54mm_Vertical
J5: LCD 1602 I2C DISPLAY
J6: WATER LEVEL SENSOR
J7: MAIN DISPENSE BUTTON
J8: SOLUTION LEVEL SENSOR
J9: WATER DISPENSE BUTTON
J10: LASER SENSOR
K2: MEDICINE PUMP RELAY; Relay_SPDT_Fujitsu_FTR-LYCA005x_FormC_Vertical
K3: WATER PUMP RELAY; Relay_SPDT_Fujitsu_FTR-LYCA005x_FormC_Vertical
M1: Motor_Servo
MEDICINE_PUMP: Motor_DC
R1, R2, R3, R4: R
SOLUTION_FILL_SWITCH: SW_SPST
U1: NODEMCU V3 ESP8266; Olimex_MOD-WIFI-ESP8266-DEV
U2: DHT22; Aosong_DHT11_5.5x12.0_P2.54mm
U3: Hall Effect Sensor; SOT-23
WATER_FILL_SWITCH: SW_SPST
WATER_PUMP1: Motor_DC

Connections:
+3V3: J1.2, U1.1 (3.3V)
+5V: J1.12, J5.3, J6.1, J7.1, J8.1, J9.1, M1.2 (+), SOLUTION_FILL_SWITCH.2 (B), U2.1 (VDD), U3.1 (VCC), WATER_FILL_SWITCH.2 (B)
+24V: J10.1, K2.11, K3.11
A1: J1.5, U2.2 (DATA)
A2: J1.6
A4/SDA: J1.8, J5.1
A5/SCL: J1.9, J5.2
A6: J1.10
A7: J1.11
AREF: J1.3
D0/RX: J2.14
D1/TX: J2.15
D2: J2.11, U1.3 (GPIO1)
D7: J2.6, R4.1, SOLUTION_FILL_SWITCH.1 (A)
D8: J2.5, U3.2 (OUTPUT)
D12/MISO: J2.1, K3.A1
D13/SCK: BZ1.1 (+), D1.2 (A), J1.1
GND: BZ1.2 (-), D1.1 (K), J1.14, J2.12, J5.4, J6.3, J7.3, J8.3, J9.3, J10.3, K2.A2, K3.A2, M1.3 (-), MEDICINE_PUMP.2 (-), R2.2, R3.2, R4.2, U2.4 (GND), U3.3 (GND), WATER_PUMP1.2 (-)
unnamed: K2.14, MEDICINE_PUMP.1 (+)
unnamed: K3.14, WATER_PUMP1.1 (+)
unnamed: R1.2, R2.1, U1.4 (GPIO3)
VCC: J1.15
d3: J2.10, R1.1
d5: J2.8, K2.A1
d6: J2.7, R3.1, WATER_FILL_SWITCH.1 (A)
d9: J1.4, J1.7, J2.4, J2.9, J6.2, J7.2, J8.2, J9.2
d10/ss: J2.3, J10.2
d11/mosi: J2.2, M1.1 (PWM)
~RESET: J1.13, J2.13
